tanisperez/tfg/station/CC3000/README.md

## Estación meteorologica

El software de la estación meteorológica contiene librerías desarrolladas por otros autores. En este repositorio no se provee dichas librerías, pero pueden ser descagadas desde las páginas de los respectivos autores:

* **Adafruit_CC3000.h**
https://github.com/adafruit/Adafruit_CC3000_Library
* **Adafruit_BMP085.h**
https://github.com/adafruit/Adafruit-BMP085-Library
* **Adafruit DHT Sensor Library**
https://github.com/adafruit/DHT-sensor-library
* **Base64 Library by Adam Rudd**
https://github.com/adamvr/arduino-base64
* **JSMN JSON Library by zserge**
http://zserge.com/jsmn.html

## Directorios

* En la carpeta **schemas/** se encuentran esquemas del montaje físico de la estación meteorológica y de sus componentes para las pruebas.
* En la carpeta **photos/** se pueden encontra imágenes de la estación meteorológica.

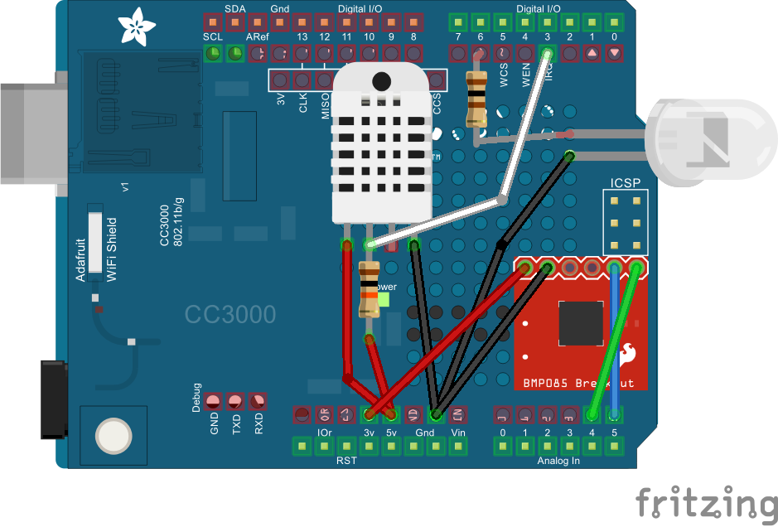
[picture p2: station/CC3000/schemas/schema2.png]
Schema
