tanisperez/tfg/web/README.md

## Aplicación web

La aplicación web requiere tener instalado en el sistema Node.js y la herramienta npm. Tras descargar el código fuente es necesario instalar los módulos. Para ello ejecutamos el siguiente comando dentro de la carpeta de la aplicación web.

> npm install

El servicio se arranca mediante el comnado:

> npm start
