tanisperez/tfg/station/CC3000/schemas/BMP180.png

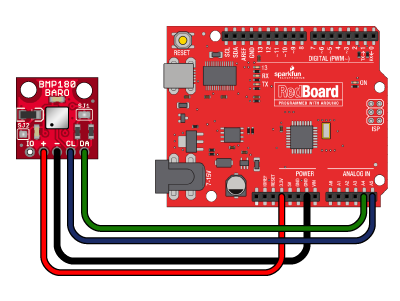
station/CC3000/schemas/BMP180.png
