tanisperez/tfg/station/CC3000/schemas/schema1.png

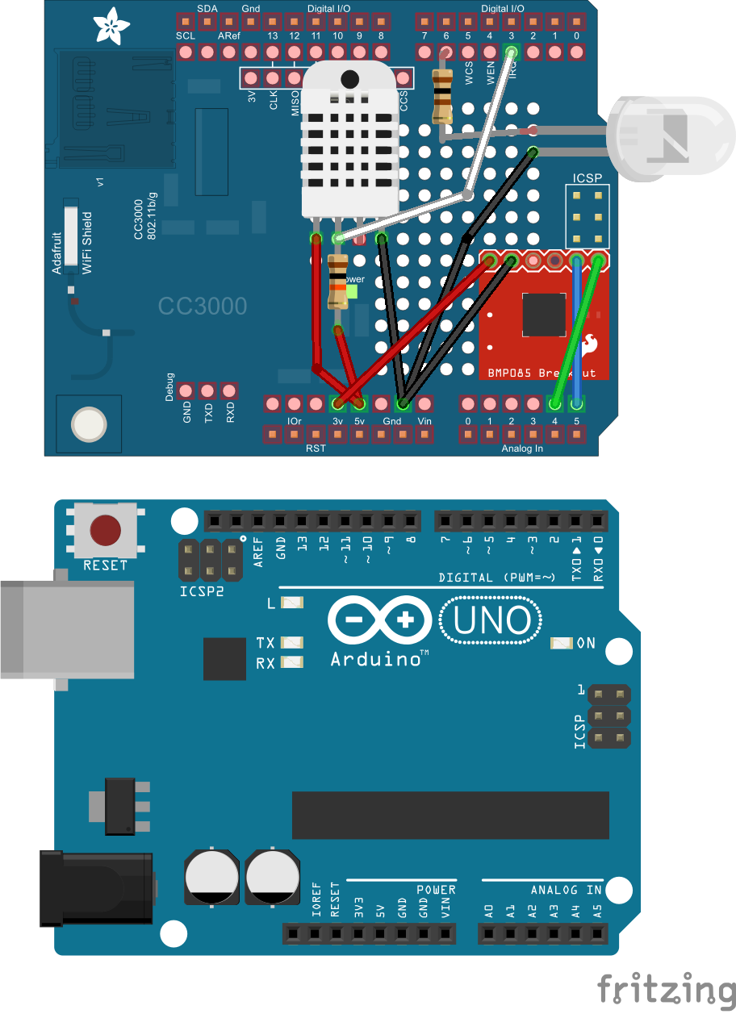
station/CC3000/schemas/schema1.png
