tanisperez/tfg/(commit log)

2015-09-07 Update README.MD
    Actualizado el fichero README.MD ofreciendo una descripción más detallada.
2015-09-07 Añadiendo la memoria del tfg
2015-09-07 Añadiendo el código fuente del servicio REST
2015-09-07 Eliminado el archivo .gitignore
2015-09-07 Añadido el código fuente de la estación meteorológica y de la aplicación web
2015-09-14 Añadido el fichero README.md de la estación meteorológica
2015-09-14 Añadidos los esquemas de la estación y fotos del montaje
2015-09-15 Corregido un fallo que mostraba las contraseñas en la petición GET /users y ahora los usuarios pueden editar correctamente sus datos del perfil
